aesanchez/equalizador-audio/README.md

# Ecualizador de audio de 4 bandas

Proyecto de procesamiento digital mediante la placa de desarrollo de la EDU-CIAA, con el fin de implementar un ecualizador de audio de 4 bandas mediante circuitos de acondicionamiento de señales y filtros digitales FIR.
