aesanchez/equalizador-audio/kicad_files/equalizador_audio.kicad_pcb

## KiCad design kicad_files/equalizador_audio.kicad_pcb (2019-03-27)

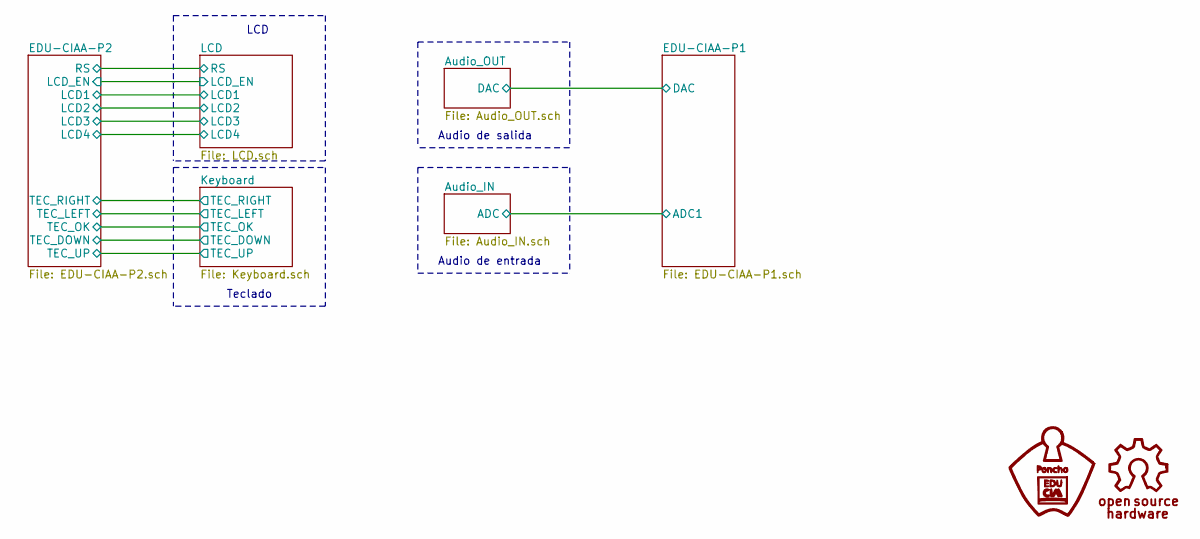
[picture p1: schematic equalizador_audio.sch, Poncho Equalizador de Audio]

Notes on the sheet:
Teclado
Audio de entrada
Audio de salida
LCD

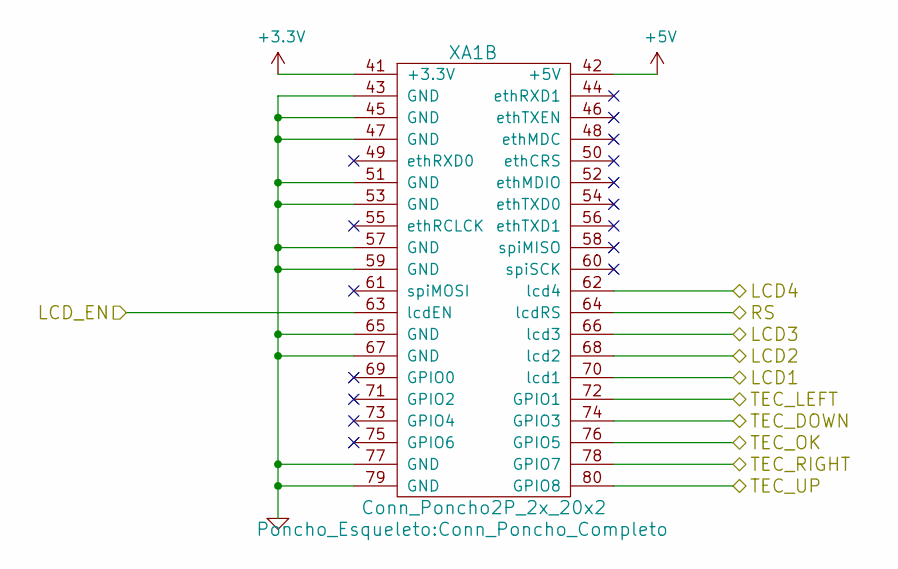
[picture p2: schematic EDU-CIAA-P2.sch, Poncho Equalizador de Audio]

Parts:
XA1: Conn_Poncho2P_2x_20x2; Conn_Poncho_Completo

Connections:
+3V3: XA1.41 (+3.3V); also elsewhere on the board
+5V: XA1.42 (+5V); also elsewhere on the board
/EDU-CIAA-P2/LCD1: XA1.70 (lcd1); also elsewhere on the board
/EDU-CIAA-P2/LCD2: XA1.68 (lcd2); also elsewhere on the board
/EDU-CIAA-P2/LCD3: XA1.66 (lcd3); also elsewhere on the board
/EDU-CIAA-P2/LCD4: XA1.62 (lcd4); also elsewhere on the board
/EDU-CIAA-P2/LCD_EN: XA1.63 (lcdEN); also elsewhere on the board
/EDU-CIAA-P2/RS: XA1.64 (lcdRS); also elsewhere on the board
/EDU-CIAA-P2/TEC_DOWN: XA1.74 (GPIO3); also elsewhere on the board
/EDU-CIAA-P2/TEC_LEFT: XA1.72 (GPIO1); also elsewhere on the board
/EDU-CIAA-P2/TEC_OK: XA1.76 (GPIO5); also elsewhere on the board
/EDU-CIAA-P2/TEC_RIGHT: XA1.78 (GPIO7); also elsewhere on the board
/EDU-CIAA-P2/TEC_UP: XA1.80 (GPIO8); also elsewhere on the board
GND: XA1.43 (GND), XA1.45 (GND), XA1.47 (GND), XA1.51 (GND), XA1.53 (GND), XA1.57 (GND), XA1.59 (GND), XA1.65 (GND), XA1.67 (GND), XA1.77 (GND), XA1.79 (GND); also elsewhere on the board

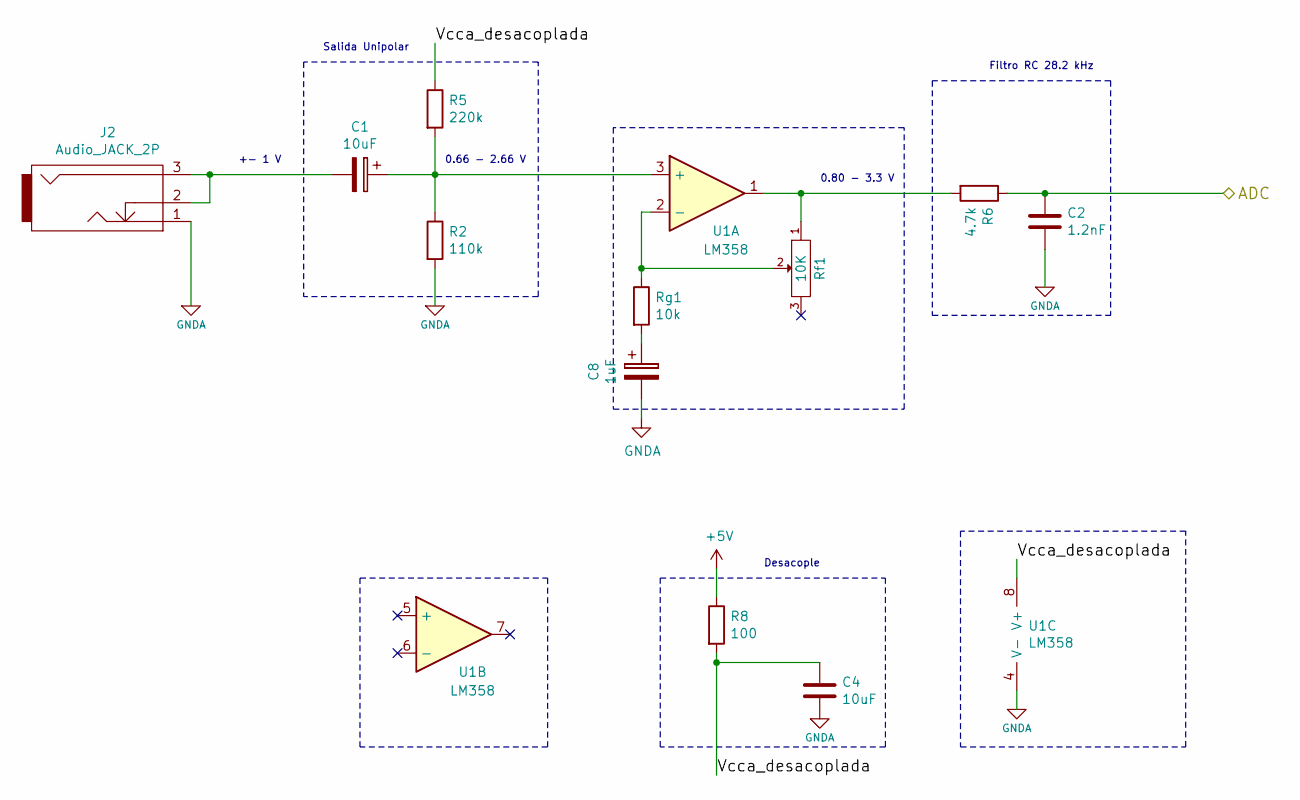
[picture p3: schematic Audio_IN.sch, Poncho Equalizador de Audio]

Parts:
C1, C4: 10uF; CP_Radial_D5.0mm_P2.50mm
C2: 1.2nF; C_Disc_D5.0mm_W2.5mm_P5.00mm
C8: 1uF; CP_Radial_D5.0mm_P2.50mm
J2: Audio_JACK_2P; Jack_Horizontal
R2: 110k; R_Axial_DIN0207_L6.3mm_D2.5mm_P10.16mm_Horizontal
R5: 220k; R_Axial_DIN0207_L6.3mm_D2.5mm_P10.16mm_Horizontal
R6: 4.7k; R_Axial_DIN0207_L6.3mm_D2.5mm_P10.16mm_Horizontal
R8: 100; R_Axial_DIN0207_L6.3mm_D2.5mm_P10.16mm_Horizontal
Rf1: 10K; Potentiometer_Bourns_3386F_Vertical
Rg1: 10k; R_Axial_DIN0207_L6.3mm_D2.5mm_P10.16mm_Horizontal
U1: LM358; DIP-8_W10.16mm

Connections:
+5V: R8.1; also elsewhere on the board
/Audio_IN/ADC: C2.2, R6.1; also elsewhere on the board
/Audio_IN/Vcca_desacoplada: C4.1, R5.1, R8.2, U1.8 (V+)
GNDA: C2.1, C4.2, C8.2, J2.1, R2.2, U1.4 (V-); also elsewhere on the board
unnamed: C1.1, R2.1, R5.2, U1.3 (+)
unnamed: C1.2, J2.2, J2.3
unnamed: C8.1, Rg1.2
unnamed: R6.2, Rf1.1, U1.1
unnamed: Rf1.2, Rg1.1, U1.2 (-)

Notes on the sheet:
0.66 - 2.66 V
0.80 - 3.3 V
Salida Unipolar
Filtro RC 28.2 kHz
Desacople
+- 1 V

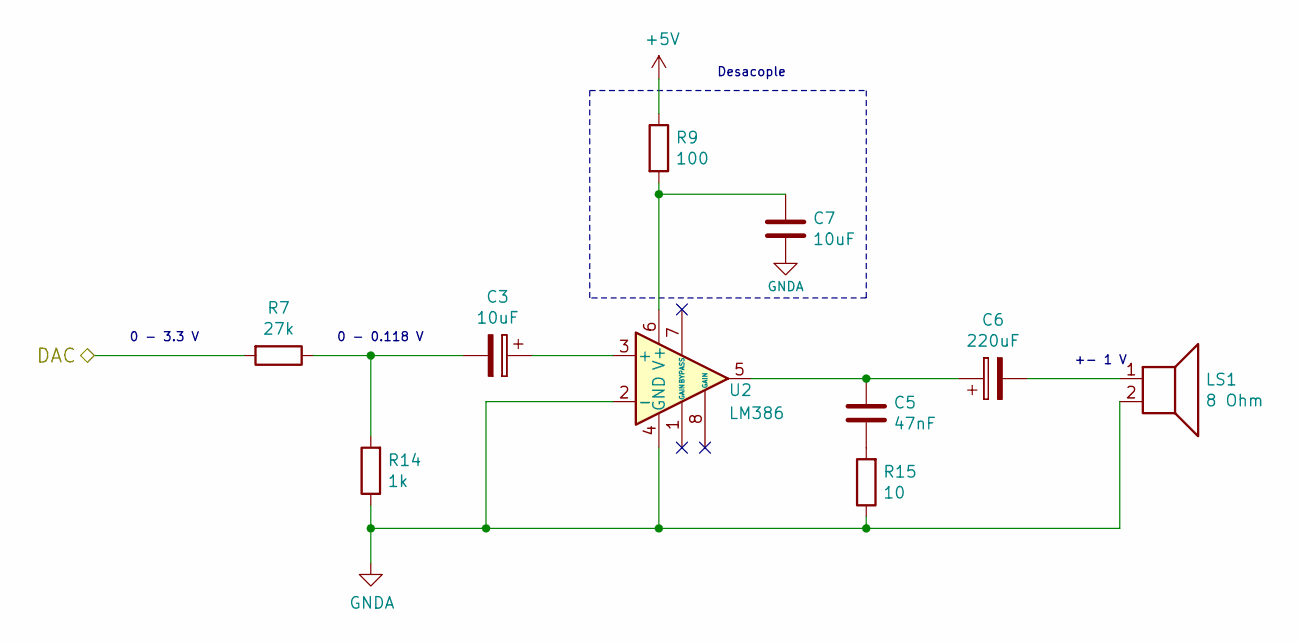
[picture p4: schematic Audio_OUT.sch, Poncho Equalizador de Audio]

Parts:
C3, C7: 10uF; CP_Radial_D5.0mm_P2.50mm
C5: 47nF; C_Disc_D5.0mm_W2.5mm_P5.00mm
C6: 220uF; CP_Radial_D5.0mm_P2.50mm
LS1: 8 Ohm; TerminalBlock_bornier-2_P5.08mm
R7: 27k; R_Axial_DIN0207_L6.3mm_D2.5mm_P10.16mm_Horizontal
R9: 100; R_Axial_DIN0207_L6.3mm_D2.5mm_P10.16mm_Horizontal
R14: 1k; R_Axial_DIN0207_L6.3mm_D2.5mm_P10.16mm_Horizontal
R15: 10; R_Axial_DIN0207_L6.3mm_D2.5mm_P10.16mm_Horizontal
U2: LM386; DIP-8_W10.16mm

Connections:
+5V: R9.1; also elsewhere on the board
/Audio_OUT/DAC: R7.2; also elsewhere on the board
GNDA: C7.2, LS1.2, R14.1, R15.1, U2.2 (-), U2.4 (GND); also elsewhere on the board
unnamed: C3.1, U2.3 (+)
unnamed: C3.2, R7.1, R14.2
unnamed: C5.1, R15.2
unnamed: C5.2, C6.1, U2.5
unnamed: C6.2, LS1.1
unnamed: C7.1, R9.2, U2.6 (V+)

Notes on the sheet:
Desacople
0 - 3.3 V
0 - 0.118 V
+- 1 V

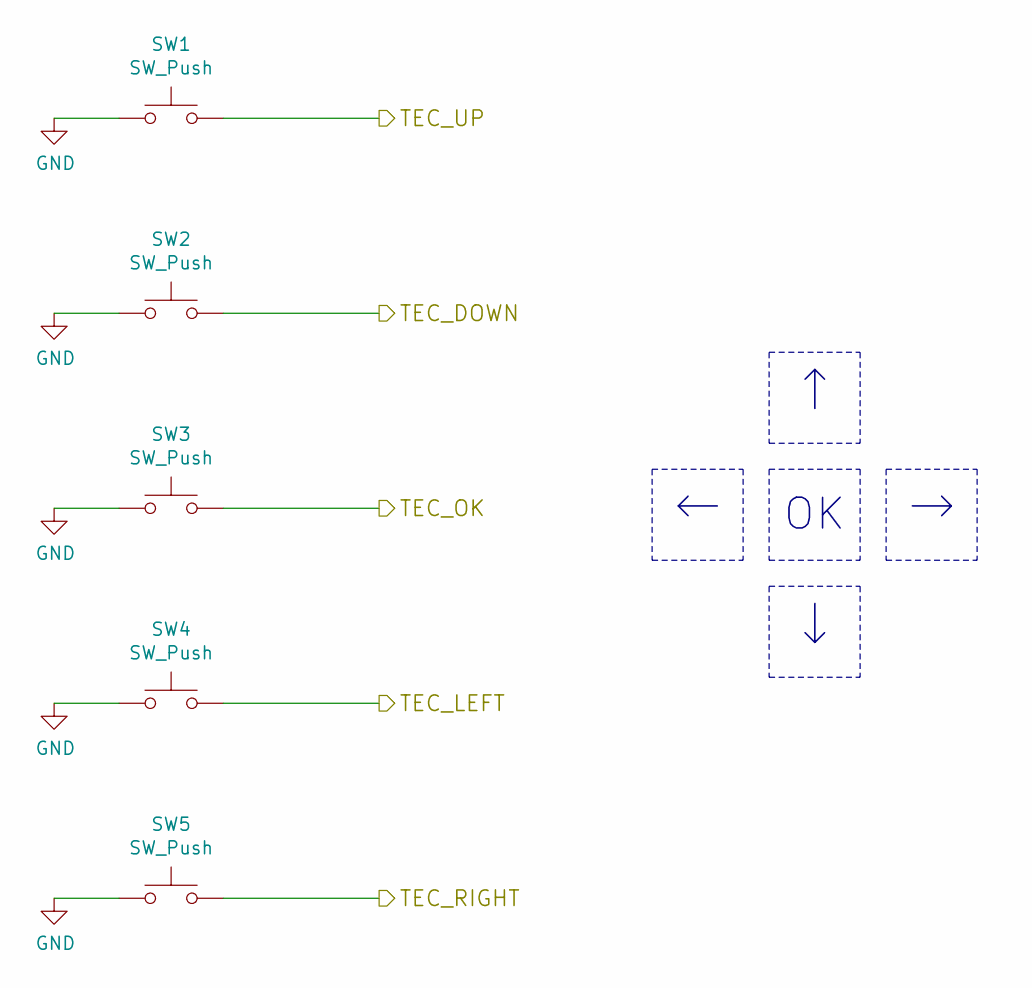
[picture p5: schematic Keyboard.sch]

Parts:
SW1, SW2, SW3, SW4, SW5: SW_Push; SW_PUSH_6mm_H5mm

Connections:
/EDU-CIAA-P2/TEC_DOWN: SW2.2; also elsewhere on the board
/EDU-CIAA-P2/TEC_LEFT: SW4.2; also elsewhere on the board
/EDU-CIAA-P2/TEC_OK: SW3.2; also elsewhere on the board
/EDU-CIAA-P2/TEC_RIGHT: SW5.2; also elsewhere on the board
/EDU-CIAA-P2/TEC_UP: SW1.2; also elsewhere on the board
GND: SW1.1, SW2.1, SW3.1, SW4.1, SW5.1; also elsewhere on the board

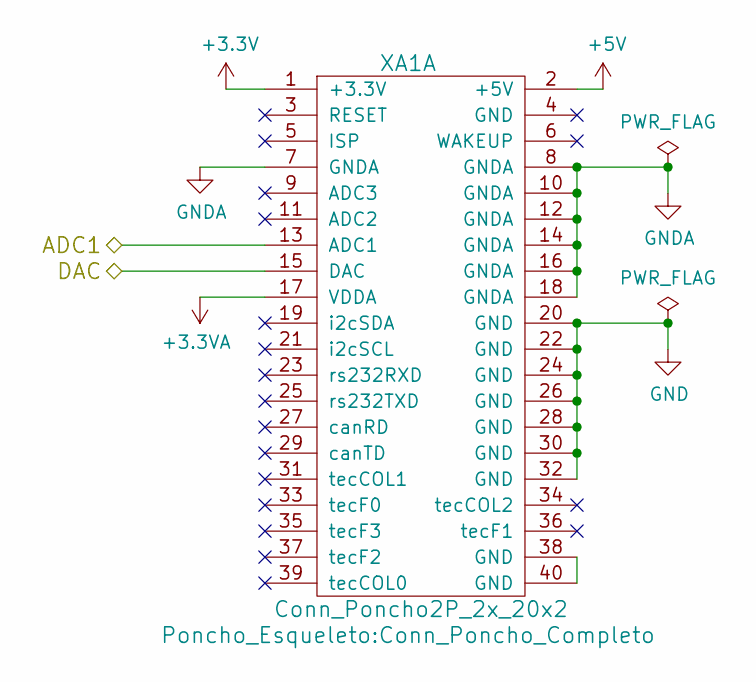
[picture p6: schematic EDU-CIAA-P1.sch, Poncho Equalizador de Audio]

Parts:
XA1: Conn_Poncho2P_2x_20x2; Conn_Poncho_Completo

Connections:
+3.3VA: XA1.17 (VDDA)
+3V3: XA1.1 (+3.3V); also elsewhere on the board
+5V: XA1.2 (+5V); also elsewhere on the board
/Audio_IN/ADC: XA1.13 (ADC1); also elsewhere on the board
/Audio_OUT/DAC: XA1.15 (DAC); also elsewhere on the board
GND: XA1.20 (GND), XA1.22 (GND), XA1.24 (GND), XA1.26 (GND), XA1.28 (GND), XA1.30 (GND), XA1.32 (GND); also elsewhere on the board
GNDA: XA1.7 (GNDA), XA1.8 (GNDA), XA1.10 (GNDA), XA1.12 (GNDA), XA1.14 (GNDA), XA1.16 (GNDA), XA1.18 (GNDA); also elsewhere on the board
unnamed: XA1.38 (GND), XA1.40 (GND)

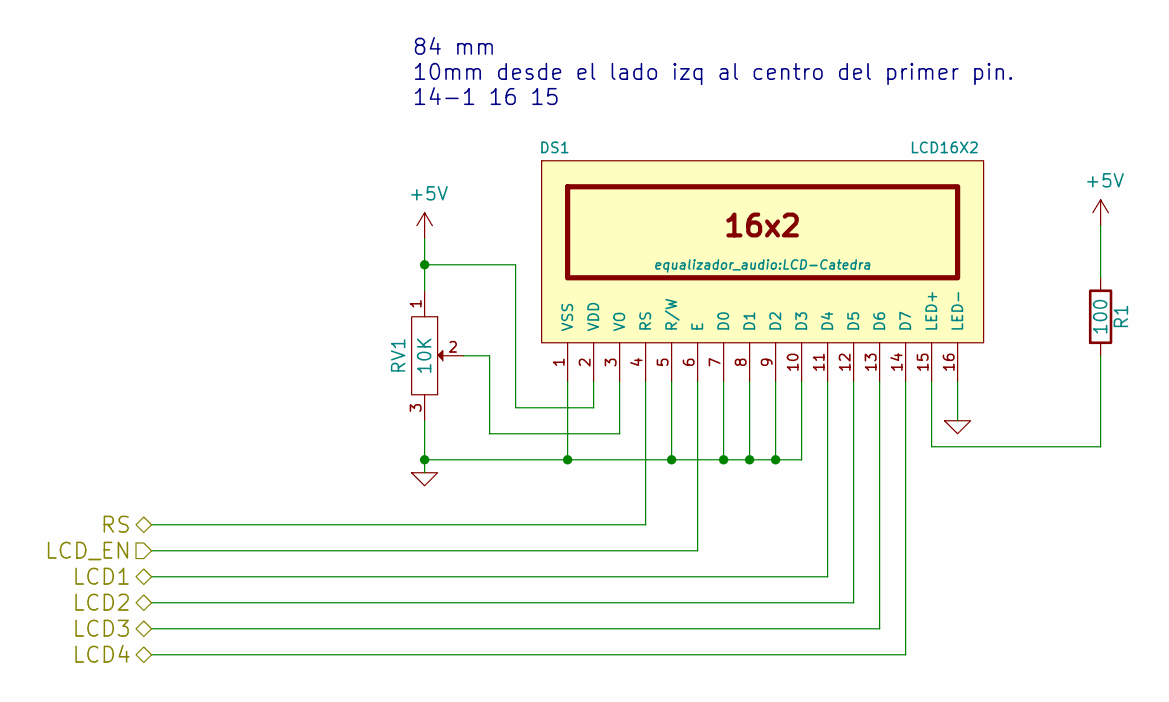
[picture p7: schematic LCD.sch]

Parts:
DS1: LCD16X2; LCD-Catedra
R1: 100; R_Axial_DIN0207_L6.3mm_D2.5mm_P10.16mm_Horizontal
RV1: 10K; Potentiometer_Bourns_3386P_Vertical

Connections:
+5V: DS1.2 (VDD), R1.1, RV1.1; also elsewhere on the board
/EDU-CIAA-P2/LCD1: DS1.11 (D4); also elsewhere on the board
/EDU-CIAA-P2/LCD2: DS1.12 (D5); also elsewhere on the board
/EDU-CIAA-P2/LCD3: DS1.13 (D6); also elsewhere on the board
/EDU-CIAA-P2/LCD4: DS1.14 (D7); also elsewhere on the board
/EDU-CIAA-P2/LCD_EN: DS1.6 (E); also elsewhere on the board
/EDU-CIAA-P2/RS: DS1.4 (RS); also elsewhere on the board
GND: DS1.1 (VSS), DS1.5 (R/W), DS1.7 (D0), DS1.8 (D1), DS1.9 (D2), DS1.10 (D3), DS1.16 (LED-), RV1.3; also elsewhere on the board
unnamed: DS1.3 (VO), RV1.2
unnamed: DS1.15 (LED+), R1.2

Notes on the sheet:
84 mm 10mm desde el lado izq al centro del primer pin. 14-1 16 15

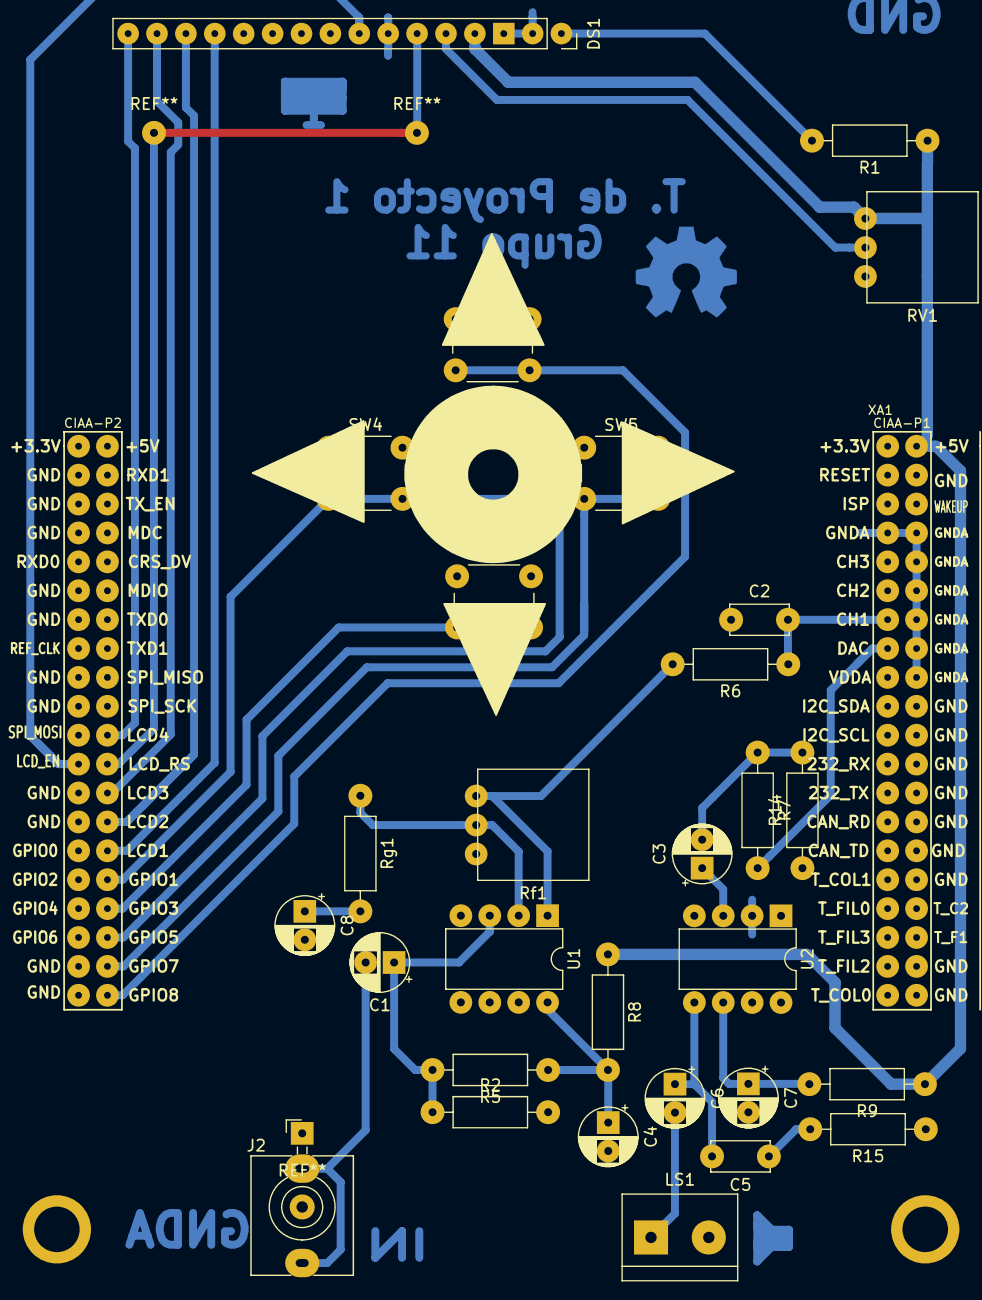
[picture p8: board equalizador_audio.kicad_pcb from above]

Board: 2 copper layers, 31 parts (0 on the bottom side), 32 nets.
