aesanchez/equalizador-audio/edu_ciaa_code/inc/filter1.h

#ifndef FILTER1_H_
#define FILTER1_H_
/*

FIR filter designed with
 http://t-filter.appspot.com

sampling frequency: 44000 Hz

fixed point precision: 32 bits

* 0 Hz - 1800 Hz
  gain = 1
  desired ripple = 2 dB
  actual ripple = n/a

* 2300 Hz - 22000 Hz
  gain = 0
  desired attenuation = -30 dB
  actual attenuation = n/a

*/

#define FILTER1_TAP_NUM 99

static int filter1_taps[FILTER1_TAP_NUM] = {
  33464563,
  1655442,
  630274,
  -1083068,
  -3394492,
  -6155285,
  -9172032,
  -12203197,
  -14987118,
  -17254036,
  -18752961,
  -19277933,
  -18671720,
  -16873006,
  -13892484,
  -9855956,
  -4998632,
  388565,
  5908555,
  11139871,
  15634217,
  18963136,
  20758054,
  20737685,
  18748373,
  14775981,
  8967958,
  1673633,
  -6765289,
  -15553971,
  -24105675,
  -31655450,
  -37412053,
  -40635119,
  -40678258,
  -37055448,
  -29470436,
  -17850089,
  -2360689,
  16597679,
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
};


#endif
