aesanchez/equalizador-audio/edu_ciaa_code/inc/filter3.h

#ifndef FILTER3_H_
#define FILTER3_H_
/*

FIR filter designed with
 http://t-filter.appspot.com

sampling frequency: 44000 Hz

fixed point precision: 32 bits

* 0 Hz - 4700 Hz
  gain = 0
  desired attenuation = -30 dB
  actual attenuation = n/a

* 5200 Hz - 9800 Hz
  gain = 1
  desired ripple = 2 dB
  actual ripple = n/a

* 10300 Hz - 22000 Hz
  gain = 0
  desired attenuation = -30 dB
  actual attenuation = n/a

*/

#define FILTER3_TAP_NUM 99

static int filter3_taps[FILTER3_TAP_NUM] = {
    21009827,
  -20616617,
  -12687711,
  -6216893,
  -9593678,
  -18518369,
  -11185773,
  17645369,
  36032739,
  14246456,
  -26524837,
  -36957106,
  -8671820,
  15562514,
  8611213,
  -2998698,
  9790696,
  25519483,
  8614759,
  -25604726,
  -30891549,
  -4687429,
  9144811,
  -2591093,
  -661832,
  30655707,
  42640309,
  -472346,
  -50607744,
  -42358745,
  2867261,
  13319035,
  -9558857,
  5474104,
  62658210,
  67148943,
  -21417332,
  -98200523,
  -62884942,
  16721238,
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
};

#endif
