aesanchez/equalizador-audio/edu_ciaa_code/inc/filter4.h

#ifndef FILTER4_H_
#define FILTER4_H_
/*

FIR filter designed with
 http://t-filter.appspot.com

sampling frequency: 44000 Hz

fixed point precision: 32 bits

* 0 Hz - 9700 Hz
  gain = 0
  desired attenuation = -30 dB
  actual attenuation = n/a

* 10200 Hz - 22000 Hz
  gain = 1
  desired ripple = 2 dB
  actual ripple = n/a

*/

#define FILTER4_TAP_NUM 93

static int filter4_taps[FILTER4_TAP_NUM] = {
  30004886,
  -67947733,
  5406020,
  14051558,
  -4546282,
  -15762262,
  -4100992,
  12639493,
  8321686,
  -10351803,
  -12412646,
  6817054,
  15522296,
  -2349334,
  -17562297,
  -3014192,
  18164370,
  8953682,
  -17088377,
  -15108100,
  14116507,
  21010164,
  -9105639,
  -26077535,
  2070117,
  29703747,
  6862327,
  -31244232,
  -17441592,
  30000365,
  29240997,
  -25292569,
  -41750968,
  16366422,
  54424055,
  -2157396,
  -66576953,
  -18945798,
  77613722,
  50417006,
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
};

#endif
