aesanchez/equalizador-audio/(commit log)

2018-09-24 esquematico placa perforada
    [schematic.fzz]
2019-02-27 Se usan funciones assembler para disminuir tiempos de calculo
2019-03-01 refactor para el proyecto
    [schematic.fzz]
2019-03-27 refactor y kicad files
    [Audio_IN.sch, Audio_OUT.sch, EDU-CIAA-P1.sch, EDU-CIAA-P2.sch, Keyboard.sch, LCD.sch, conector_poncho.sch, equalizador_audio.csv]
